MonzurulAlam/OpenVstim/Images/ArduinoUno.png

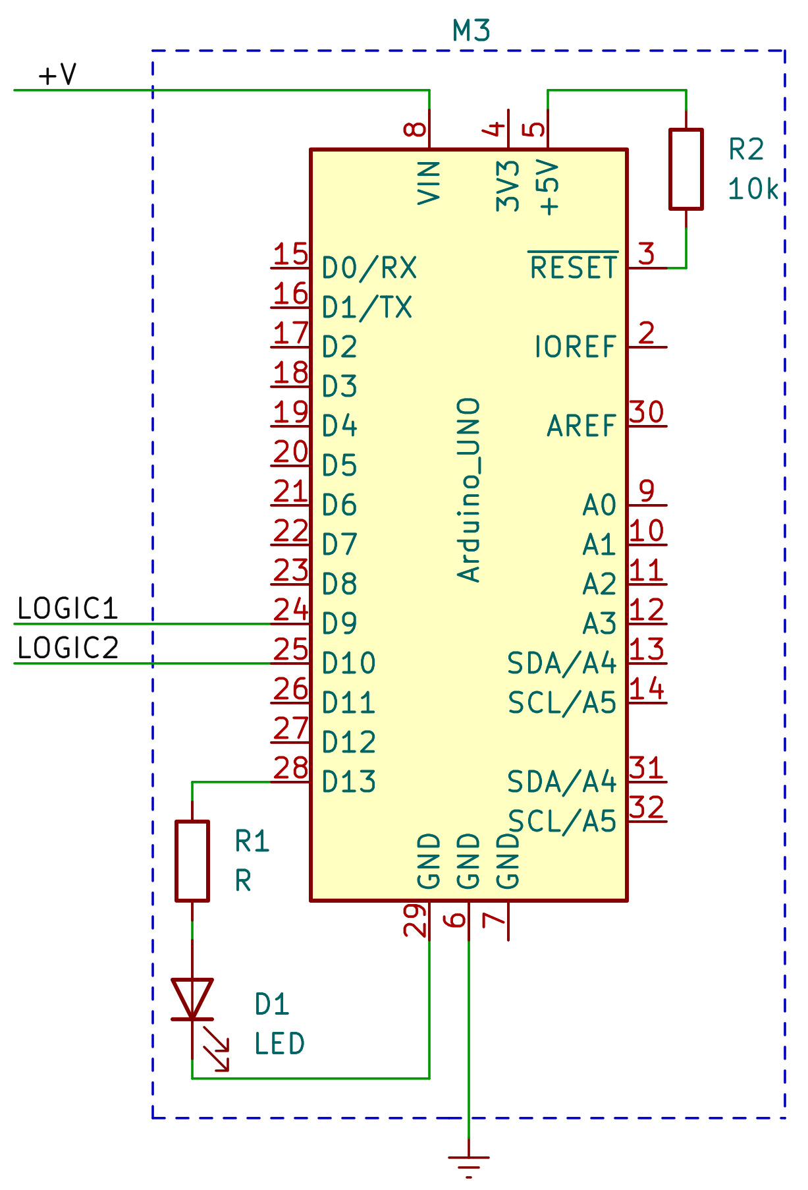
Images/ArduinoUno.png
