MonzurulAlam/OpenVstim/Images/Stimulation.png

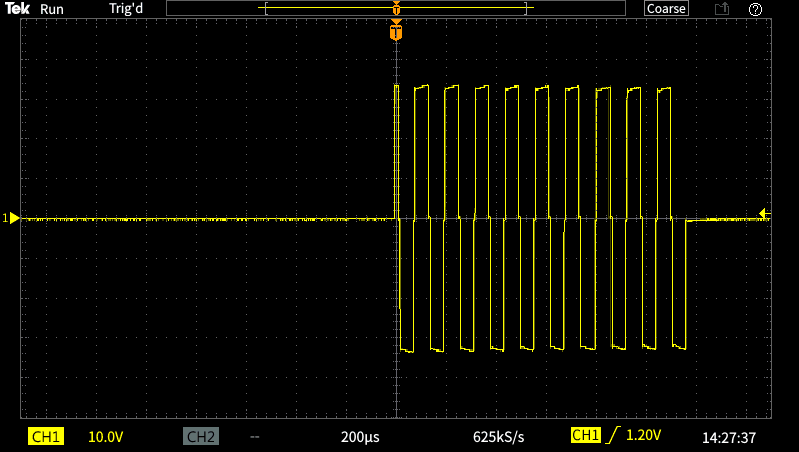
Images/Stimulation.png
