MonzurulAlam/OpenVstim/Images/Stimulator.png

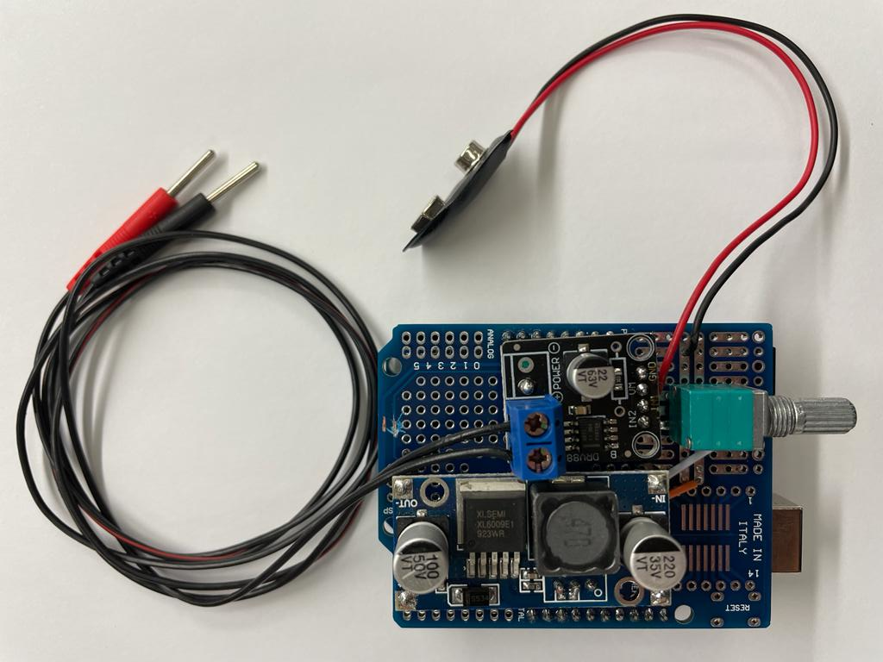
Images/Stimulator.png
