MonzurulAlam/OpenVstim/BOM.xlsx

Item no. | Item name | Model number | Description | Key feature | Units | Price (AU$) | Example source
1 | M1 | Arduino Uno | Microcontroller unit (MCU) | 8 bits | 1 | 18.95 | www.ebay.com.au/itm/402150942592
2 | M2 | XL6009 | DC-DC converter module | 50 V 1.5 A max output | 1 | 6.85 | www.ebay.com.au/itm/273707870769
3 | M3 | DRV8871 | Full H bridge module | 45 V 3.5 A max output | 1 | 17.68 | www.ebay.com.au/itm/363862724775
4 | SP1 | 10kΩ | Linear pot with on/off switch | 5 terminals | 1 | 5.35 | www.ebay.com.au/itm/153405715705
5 | J1 | Battery clip | 9 V battery clip connector | T type | 1 | 2.92 | www.ebay.com.au/itm/284538269404
6 | P1 | PCB board | Arduino Uno Shield board | For easy Prototyping | 1 | 6.99 | www.ebay.com.au/itm/392331016225
7 | W1 | TENS cable | Electrotherapy Lead wires | To connect electrodes | 1 | 2.46 | www.ebay.com.au/itm/254783965300
8 | B1 | Battery | 9V | 550 mAh | 1 | 5.45 | www.ebay.com.au/itm/384397462542
Total |  |  |  |  |  | 66.65
